HW-abc/PCIe4.0_Slot_SGMII_Ex-Board/README.md

# PCIe4.0_Slot_SGMII_Ex-Board
PCIe4.0 Slot Ex-Board, 4 channel SGMII signals
