HW-abc/PCIe4.0_Slot_SGMII_Ex-Board/HW/03_PCBA/X5H_ETHER_EX-Board_BOM_V001.xlsx

 |  | 文档编号：XXX-XX-XX-xxxxx-xxxx-xx
X5H ETHER EX-Board BOM V001 2025.12.11
Item Number | Quantity | Part Reference | Value | Part Number | Device Size | Tolerance | PCB Footprint | Description | Maker | Note
1 | 10 | B1,B5,B12,B13,B17,B18,B22,B23,B27,B28 | 33 | BLM15PX330SZ1D | 1005 |  | chip1005 | -- | murata
2 | 19 | B2,B3,B4,B6,B7,B8,B9,B10,B11,B14,B15,B16,B19,B20,B21,B24,B25,B26,B29 | 600 | BLM15AX601SZ1D | 1005 |  | chip1005 | -- | murata
3 | 5 | C1,C4,C15,C16,C28 | 10uF | GCM21BC71C106KE36 | 2012 | 10% | chip2012 | -- | murata
4 | 59 | C2,C3,C5,C6,C7,C8,C9,C10,C11,C12,C13,C14,C17,C18,C19,C20,C21,C22,C23,C24,C25,C26,C27,C30,C31,C33,C36,C39,C40,C41,C42,C43,C44,C45,C53,C54,C55,C56,C57,C58,C59,C67,C68,C69,C70,C71,C72,C73,C81,C82,C83,C84,C85,C86,C87,C102,C106,C111,C115 | 0.1uF | GCM155R71C104KA55 | 1005 | 10% | chip1005 | -- | murata
5 | 2 | C29,C32 | 0.22uF | CGA2B2X7R1C224M050B | 1005 | 10% | chip1005 | -- | TDK
6 | 21 | C34,C35,C46,C47,C48,C49,C60,C61,C62,C63,C74,C75,C76,C77,C88,C89,C90,C91,C98,C99,C116 | 0.1uF | GCM155R71H104KE02 | 1005 | 10% | chip1005 | -- | murata
7 | 10 | C37,C38,C51,C52,C65,C66,C79,C80,C93,C94 | 8pF | GCM1555C1H8R0DA16 | 1005 | 0.5pF | chip1005 | -- | murata
8 | 1 | C109 | 1nF | GCM155R71H102KA37 | 1005 | 10% | chip1005 | -- | murata
9 | 4 | C50,C64,C78,C92 | 4.7nF | GCM155R71H472KA37 | 1005 | 10% | chip1005 | -- | murata
10 | 6 | C95,C96,C100,C104,C108,C112 | 10uF | TMK316AB7106KLHT | 3216 | 10% | chip3216 | -- | TAIYO YUDEN
11 | 1 | C97 | 4.7uF | CGA4J1X7R1E475K125AD | 2012 | 10% | chip2012 | -- | TDK
12 | 4 | C101,C105,C110,C114 | 22uF | EMK325B7226KMHP | 3225 | 10% | chip3225 | -- | TAIYO YUDEN
13 | 1 | C113 | 2.2nF | GCM155R71H222KA37 | 1005 | 10% | chip1005 | -- | murata
14 | 2 | CN1,CN2 | Flash E1 | -- |  |  | jtag-e2_254h | -- | -- | pic1
15 | 4 | CN3,CN4,CN5,CN6 | E6S20A-40MT5-Z | E6S20A-40MT5-Z | 21.9x11.0x13.5mm |  | e6s20a-40mt5 | -- | Rosenberger
16 | 1 | CN7 | PJ-063AH | PJ-063AH | 13.0x10.0x0.9mm |  | pj-063ah | -- | Semtec
17 | 1 | D1 | PMEG3030EP | PMEG3030EP | 2.5x4.7x1.1mm |  | pmeg3030ep | -- | nexperia | Replacement: PMEG3020EP
18 | 4 | L1,L2,L3,L4 | ACM2012H-900 | ACM2012H-900-2P-T03 | 2.0x1.2x1.3mm |  | acm2012h-900-2p-t03 | -- | TDK
19 | 4 | L5,L6,L7,L8 | 1.0uH | IHLP1212BZEV1R0M5A | 3.3x3.3x2.0mm |  | ihlp1212bz5a | -- | Vishay
20 | 5 | LED1,LED2,LED3,LED4,LED5 | Amber | IN-S42BT5A | 1005 |  | led1005 | -- | Inolux
21 | 2 | Q1,Q3 | NX3008NBKW | NX3008NBKW,115 | 2.1x2.0x1.1mm |  | nx3008nbkw | -- | Nexperia | Replacement: NTS4409N
22 | 1 | Q2 | IPD30N03S4L | IPD30N03S4L-09 | 10.0x6.5x2.4mm |  | ipd30n03s4l | -- | Infineon
23 | 16 | R7,R10,R13,R20,R24,R25,R33,R37,R38,R46,R48,R51,R60,R79,R80,R81 | 0 | ERJ-2GE0R00X | 1005 | 5% | chip1005 | -- | Panasonic
24 | 7 | R1,R2,R5,R6,R8,R9,R62 | 10K | ERJ-2GEJ103X | 1005 | 5% | chip1005 | -- | Panasonic
25 | 17 | R4,R14,R17,R19,R26,R29,R31,R32,R39,R42,R44,R45,R52,R55,R57,R58,R59 | 4.7K | ERJ-2GEJ472X | 1005 | 5% | chip1005 | -- | Panasonic
26 | 13 | R11,R12,R16,R22,R23,R28,R35,R36,R41,R49,R50,R53,R78 | 1K | ERJ-2GEJ102X | 1005 | 5% | chip1005 | -- | Panasonic
27 | 4 | R15,R27,R40,R54 | 100K | ERJ-2GEJ104X | 1005 | 5% | chip1005 | -- | Panasonic
28 | 4 | R21,R34,R47,R61 | 4.99K | ERJ-2RKF4991X | 1005 | 1% | chip1005 | -- | Panasonic
29 | 1 | R63 | 47K | ERJ-2GEJ473X | 1005 | 5% | chip1005 | -- | Panasonic
30 | 6 | R64,R67,R71,R73,R75,R77 | 100.0K | ERJ-2RKF1003X | 1005 | 1% | chip1005 | -- | Panasonic
31 | 2 | R65,R68 | 40.2K | ERJ-2RKF4022X | 1005 | 1% | chip1005 | -- | Panasonic
32 | 1 | R69 | 21.0K | ERJ-2RKF2102X | 1005 | 1% | chip1005 | -- | Panasonic
33 | 1 | R70 | 82.0K | ERJ-2RKF8202X | 1005 | 1% | chip1005 | -- | Panasonic
34 | 2 | R72,R76 | 7.15K | ERJ-2RKF7151X | 1005 | 1% | chip1005 | -- | Panasonic
35 | 1 | R74 | 49.9K | ERJ-2RKF4992X | 1005 | 1% | chip1005 | -- | Panasonic
36 | 1 | SW1 | TACK | SKRKAGE020 | 3.9x2.9x1.5mm |  | skrkage020 | -- | ALPS
37 | 4 | SW2,SW3,SW4,SW5 | CHS-01A | CHS-01A | 5.6x2.5x2.5mm |  | chs-01a | -- | Nidec
38 | 1 | U1 | U2C_292P | PRBG0292GC-A | 17.0x17.0x1.9mm |  | u2c8_292p_080p_040b | -- | Renesas
39 | 4 | U2,U3,U4,U5 | 88Q2112 | 88Q2112 | 6.0x6.0x0.9mm |  | 88q2112_48p | -- | Marvell
40 | 4 | U6,U7,U8,U9 | TPS62903 | TPS62903QRYTRQ1 | 2.0x2.1x0.9mm |  | tps62903q1 | -- | Ti
41 | 1 | U10 | APX803S00 | APX803S00-29SR-7 | 3.0x2.4x1.1mm |  | apx810sr | -- | Diodes
42 | 1 | X1 | 20.000MHz | XRCGE20M000F3A1BR0 | 2016 | 30ppm | xtal4_crs2016 | -- | Murata
43 | 4 | X2,X3,X4,X5 | 25.000MHz | CX2016SA25000D0FPLG1 | 2016 | 10ppm | xtal4_crs2016 | -- | Kyocera
Not Mounted on Board
Item Number | Quantity | Part Reference | Value | Part Number | Device Size | Tolerance | PCB Footprint | Description | Maker | Note
1 | 1 | C103,C107 | 1nF* | GCM155R71H102KA37 | 1005 | 10% | chip1005 | -- | murata
2 | 6 | R3,R82,R83,R84,R85,R86 | 0* | ERJ-2GE0R00X | 1005 | 5% | chip1005 | -- | Panasonic
3 | 4 | R18,R30,R43,R56 | 4.7K* | ERJ-2GEJ472X | 1005 | 5% | chip1005 | -- | Panasonic
4 | 1 | R66 | 249.0K* | ERJ-2RKF2493X | 1005 | 1% | chip1005 | -- | Panasonic
5 | 1 | R87 | 100K* | ERJ-2GEJ104X | 1005 | 5% | chip1005 | -- | Panasonic
