HW-abc/PCIe4.0_Slot_SGMII_Ex-Board/HW/02_PCB/ether_ex_board_v001_1211.pdf

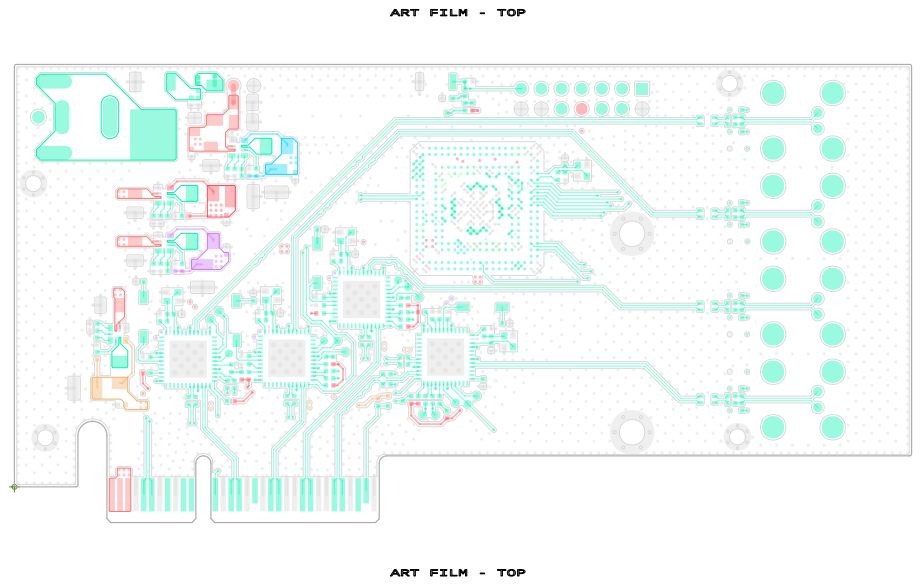
[picture p1: page 1]

ART FILM - TOP

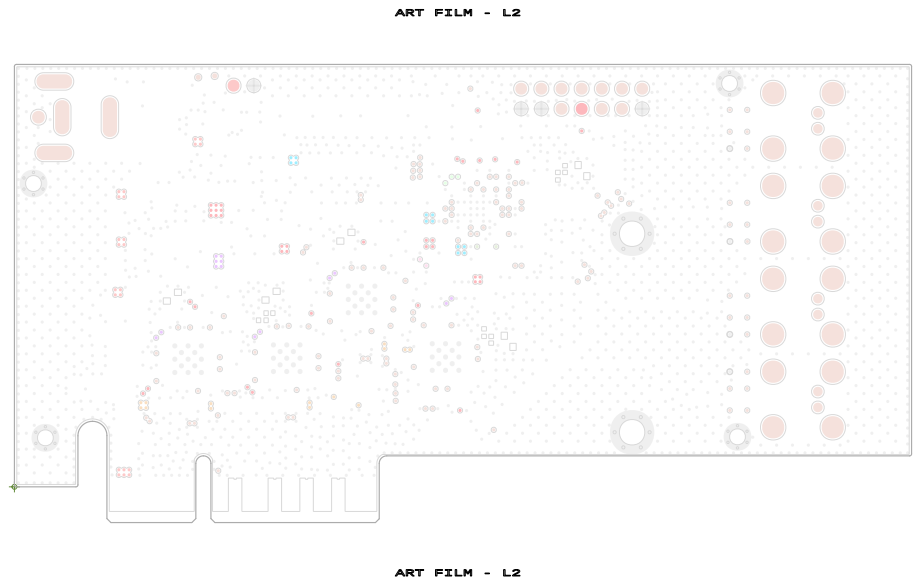
[picture p2: page 2]
ART FILM - L2

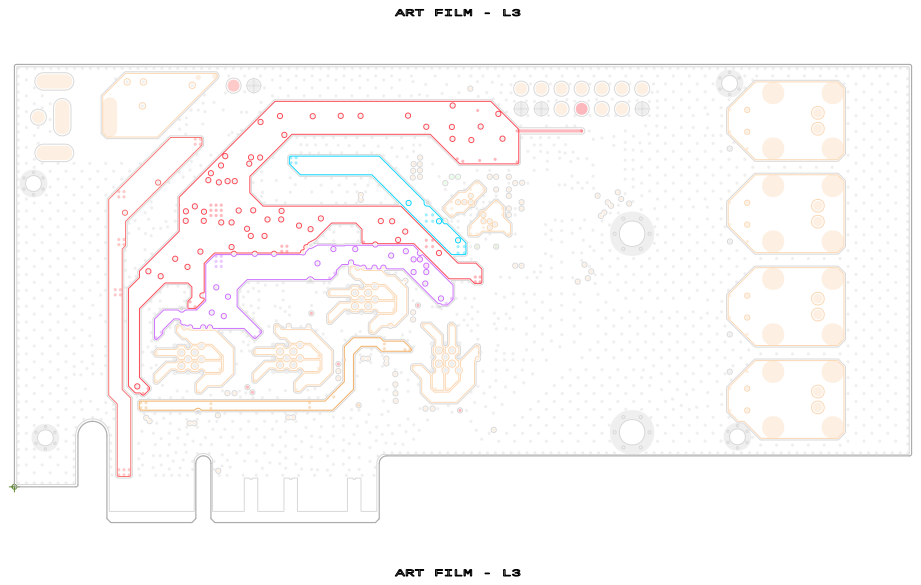
[picture p3: page 3]
ART FILM - L3

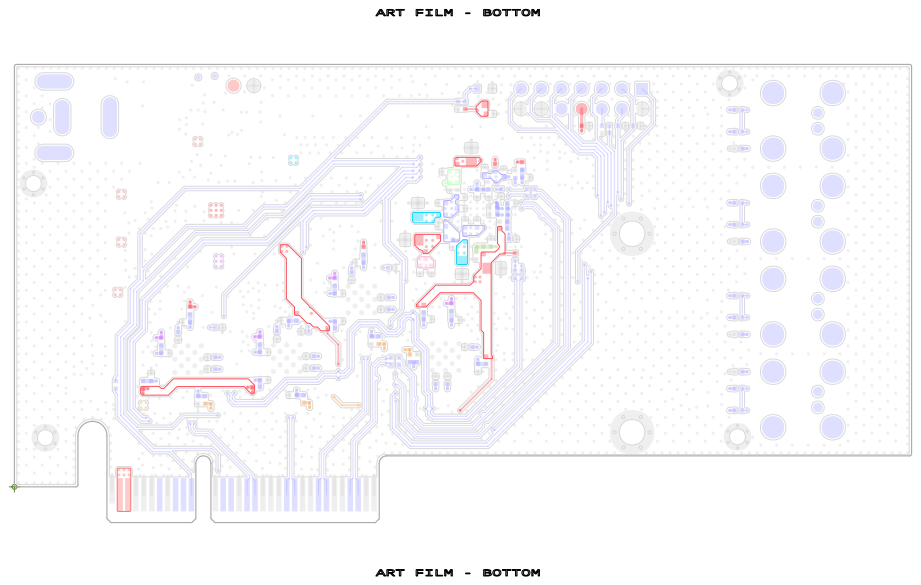
[picture p4: page 4]

ART FILM - BOTTOM

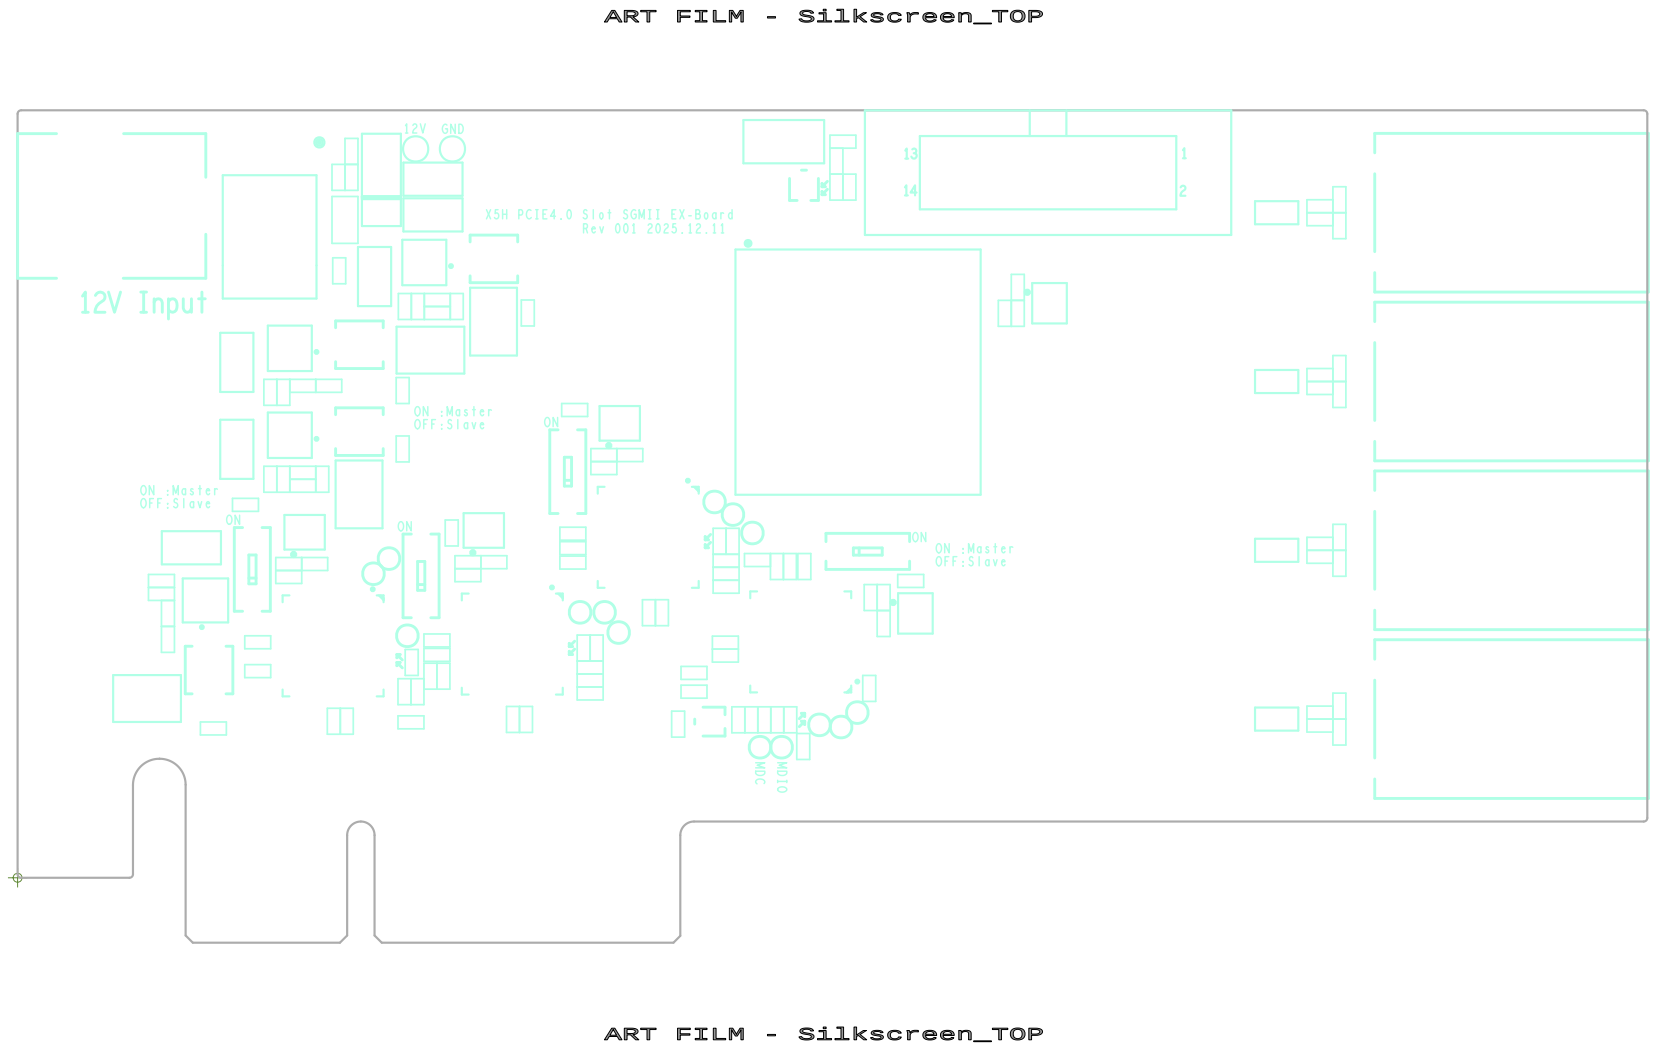
[picture p5: page 5]
ART FILM - Silkscreen_TOP; 12V Input; OFF:Slave; ON :Master; ON :Master OFF:Slave; GND; Rev 001 2025.12.11; MDC; MDIO

X5H PCIE4.0 Slot SGMII EX-Board

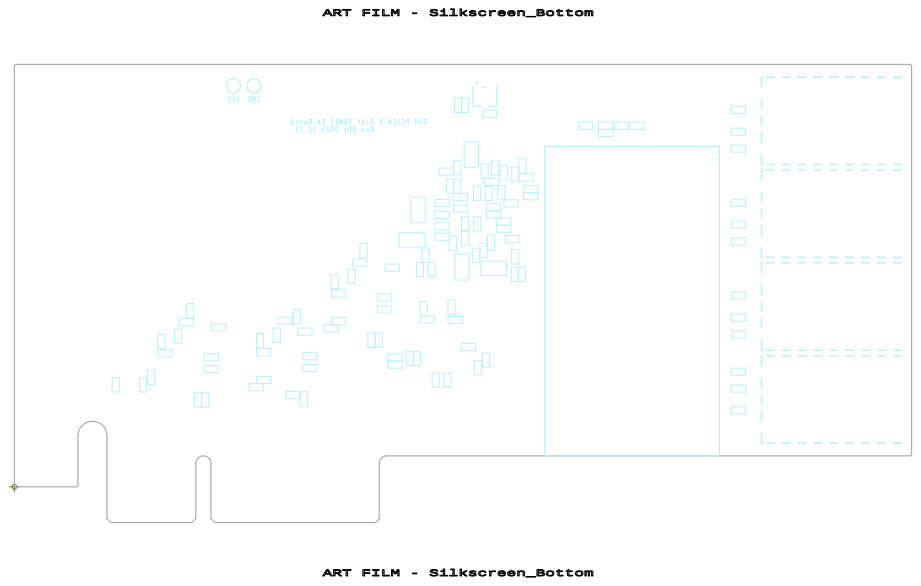
[picture p6: page 6]
ART FILM - Silkscreen_Bottom

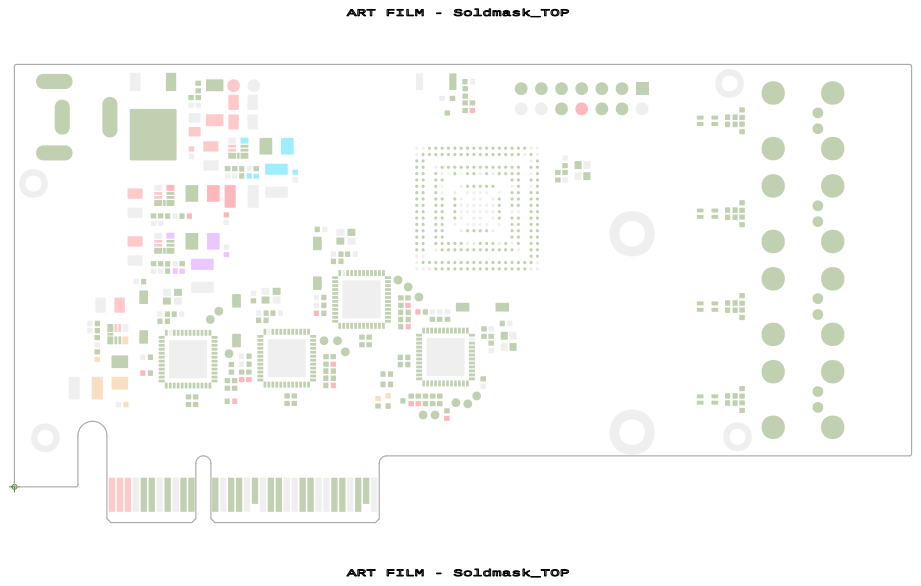
[picture p7: page 7]
ART FILM - Soldmask_TOP

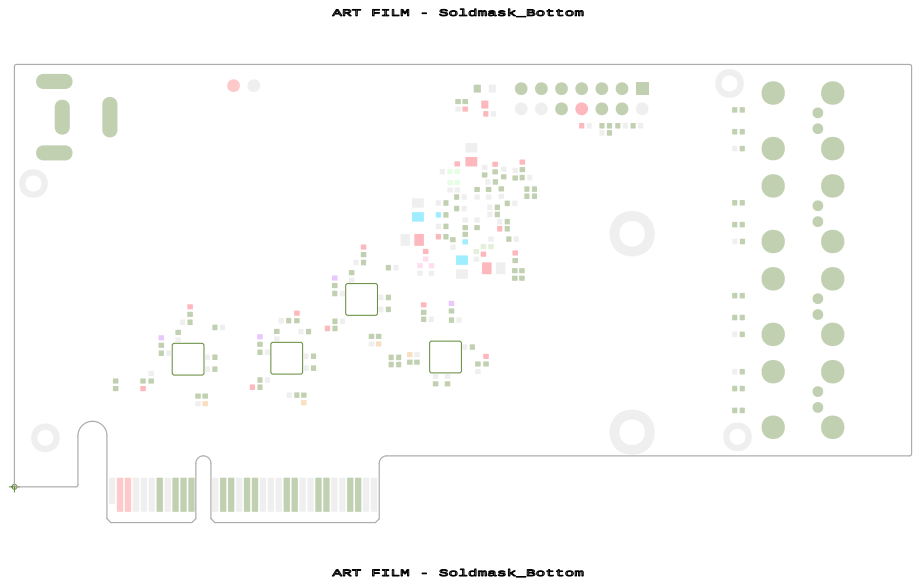
[picture p8: page 8]
ART FILM - Soldmask_Bottom

# R64C98 C97 C99 R63 R62 L8

12VR16

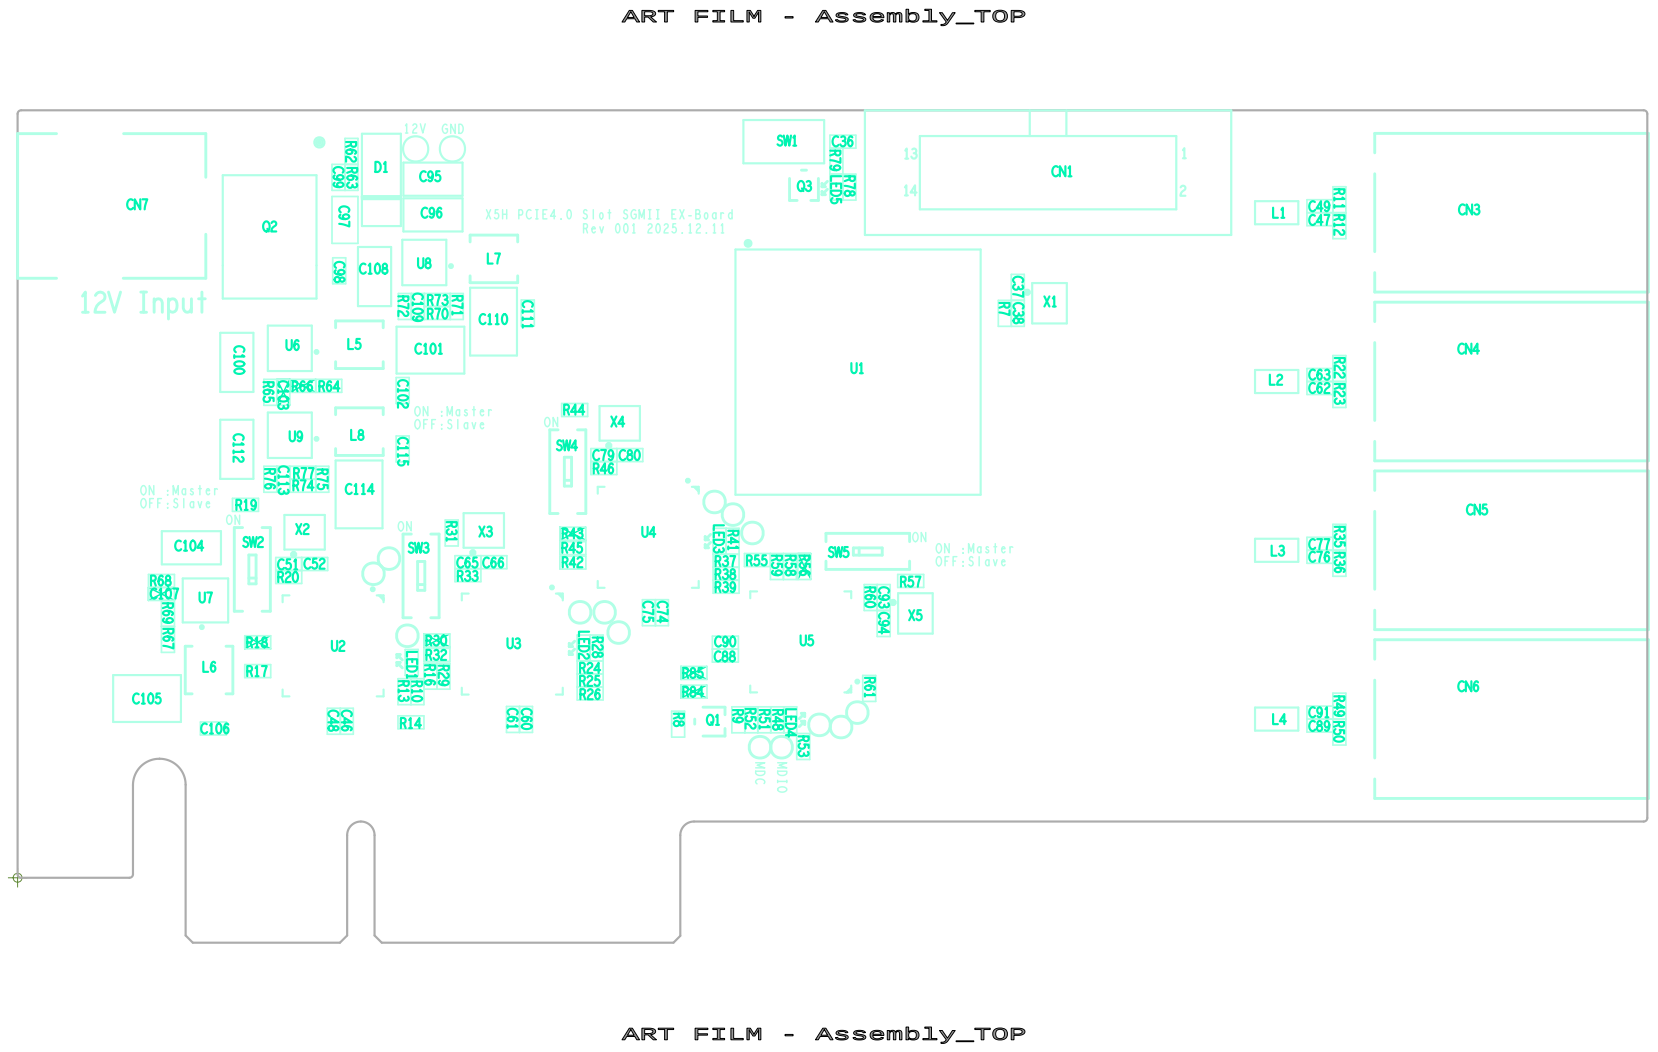
[picture p9: page 9]

X5H PCIE4.0 Slot SGMII EX-Board C61 C60

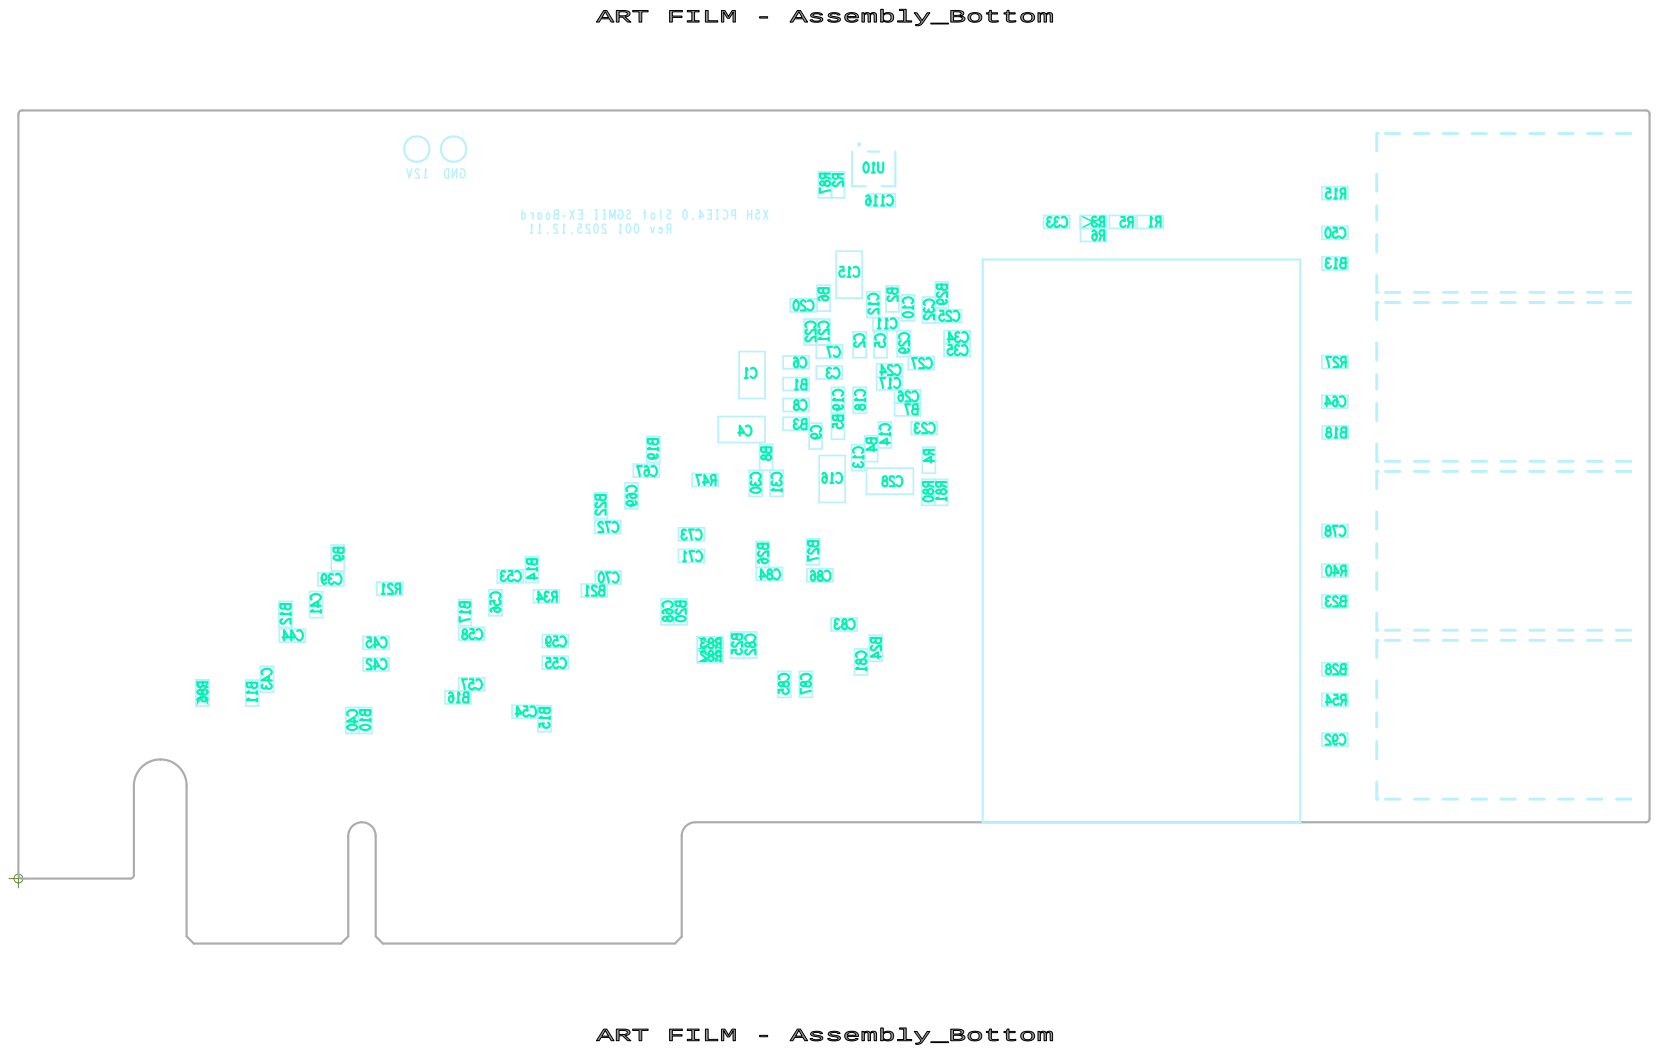
[picture p10: page 10]

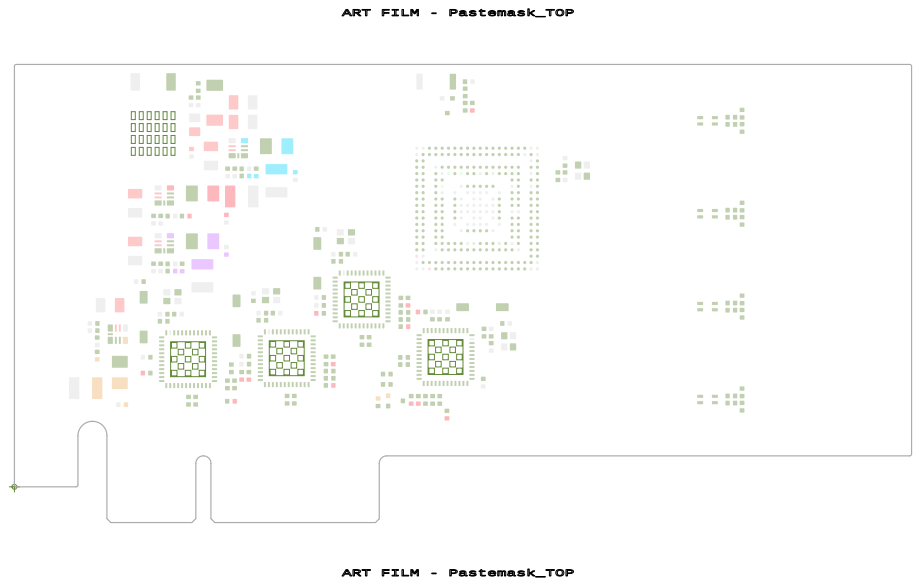
[picture p11: page 11]
ART FILM - Pastemask_TOP

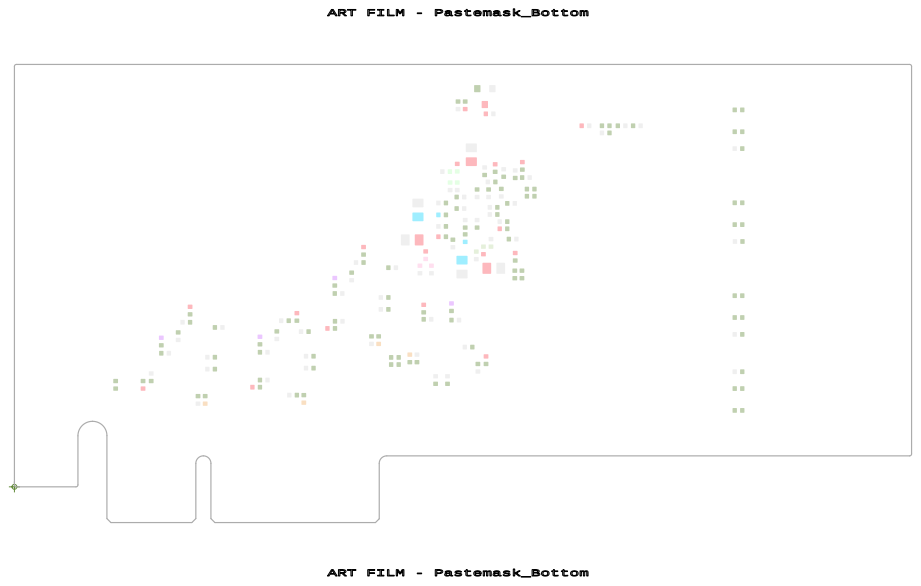
[picture p12: page 12]
ART FILM - Pastemask_Bottom

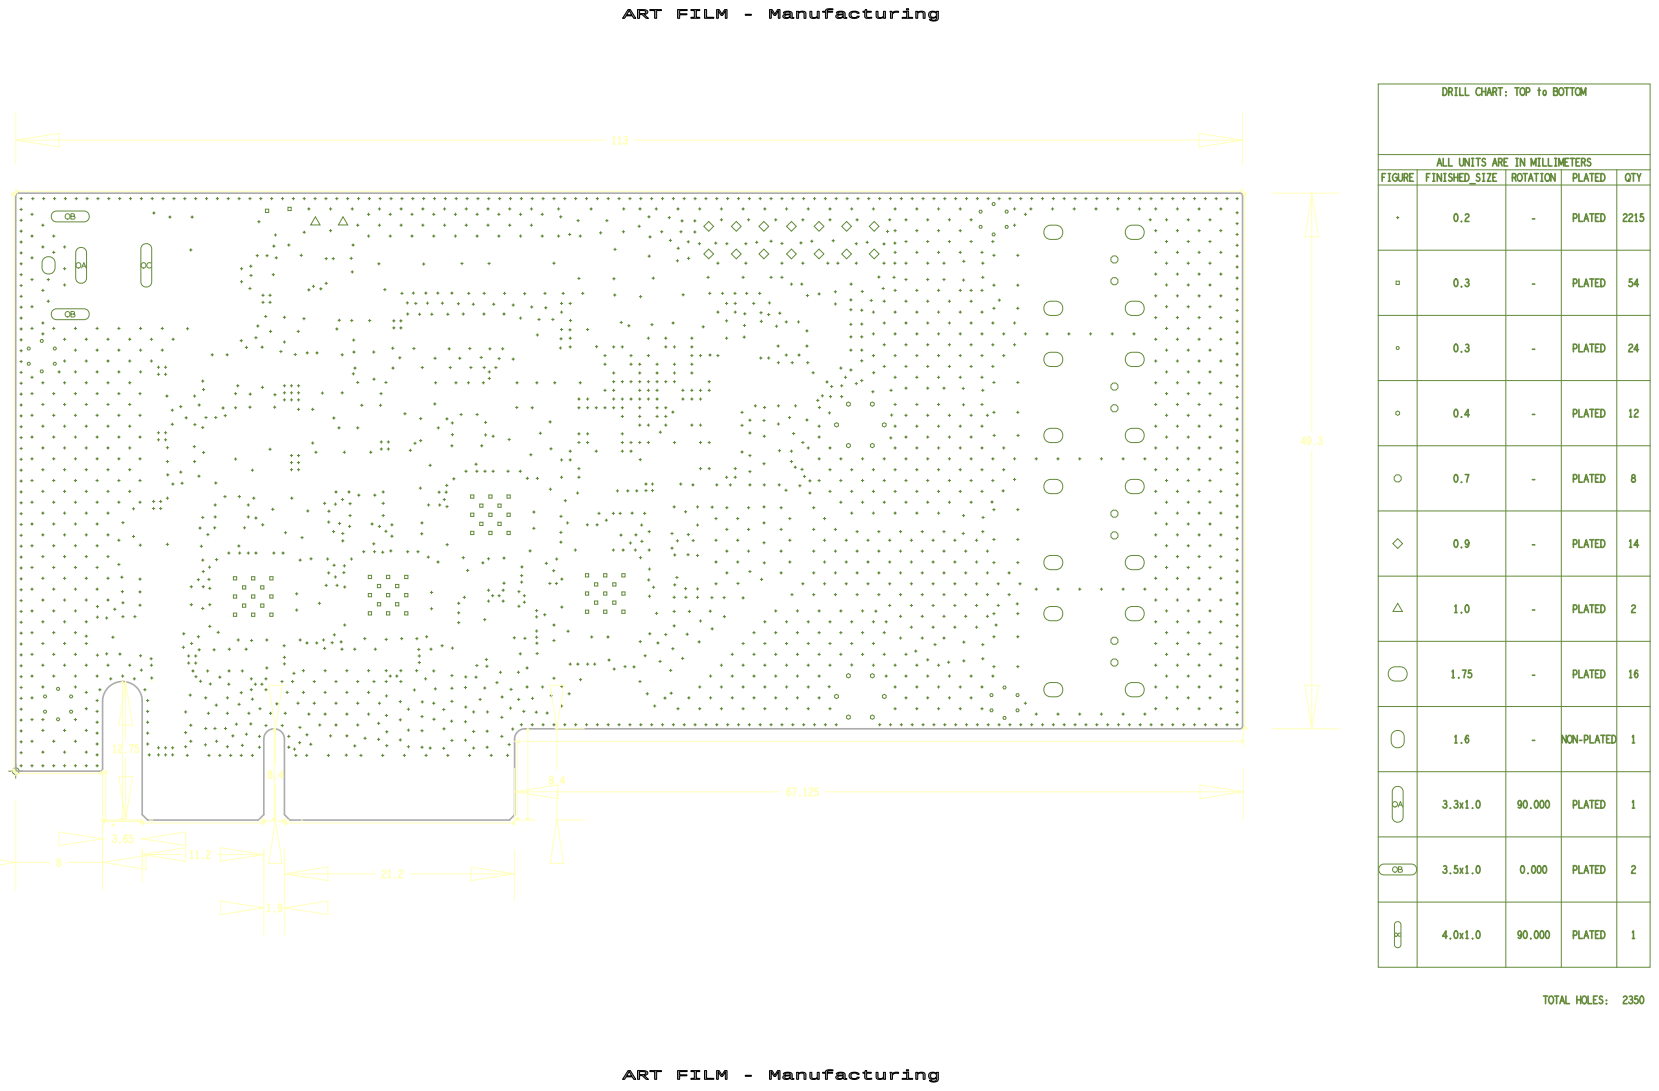
[picture p13: page 13]
FIGURE; ROTATION; TOTAL HOLES:; NON-PLATED; PLATED; QTY

ART FILM - Manufacturing

DRILL CHART: TOP to BOTTOM

ALL UNITS ARE IN MILLIMETERS
FINISHED_SIZE
