HW-abc/PCIe4.0_Slot_SGMII_Ex-Board/HW/01_SCH/ether_ex_board_v001.pdf

# max 1.0[A]

# max. 2A

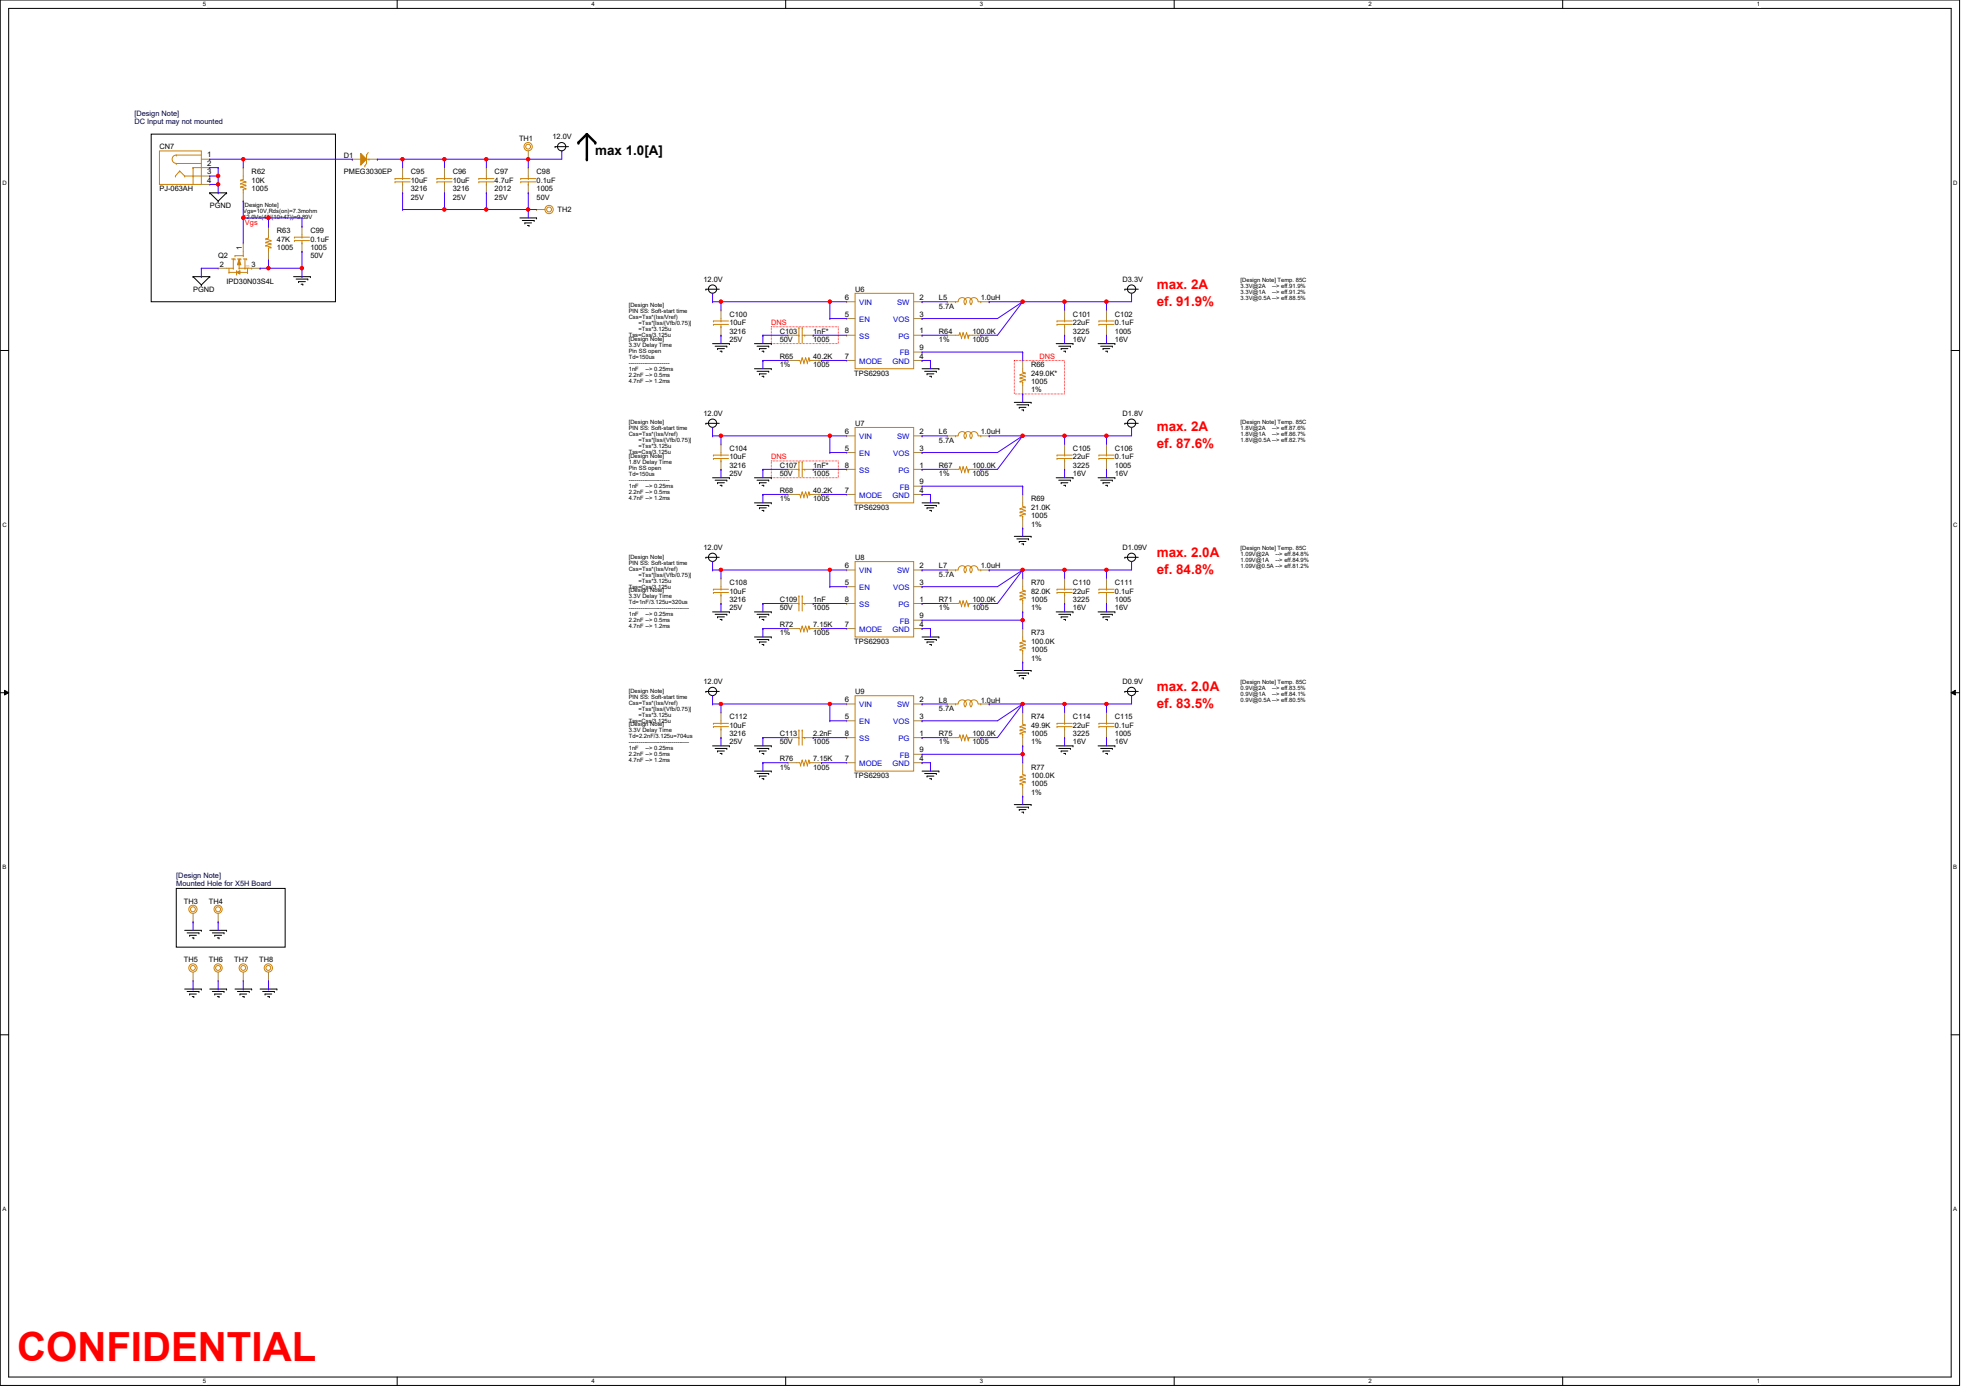
[picture p14: page 1]

[Design Note]
DC Input may not mounted

PIN SS: Soft-start time
Css=Tss*(Iss/Vref)
=Tss*[Iss/(Vfb/0.75)]
=Tss*3.125u
Tss=Css/3.125u [Design Note]
3.3V Delay Time
Pin SS open

Tss=Css/3.125u
1.8V Delay Time

Mounted Hole for X5H Board

# Preliminary

88Q2112

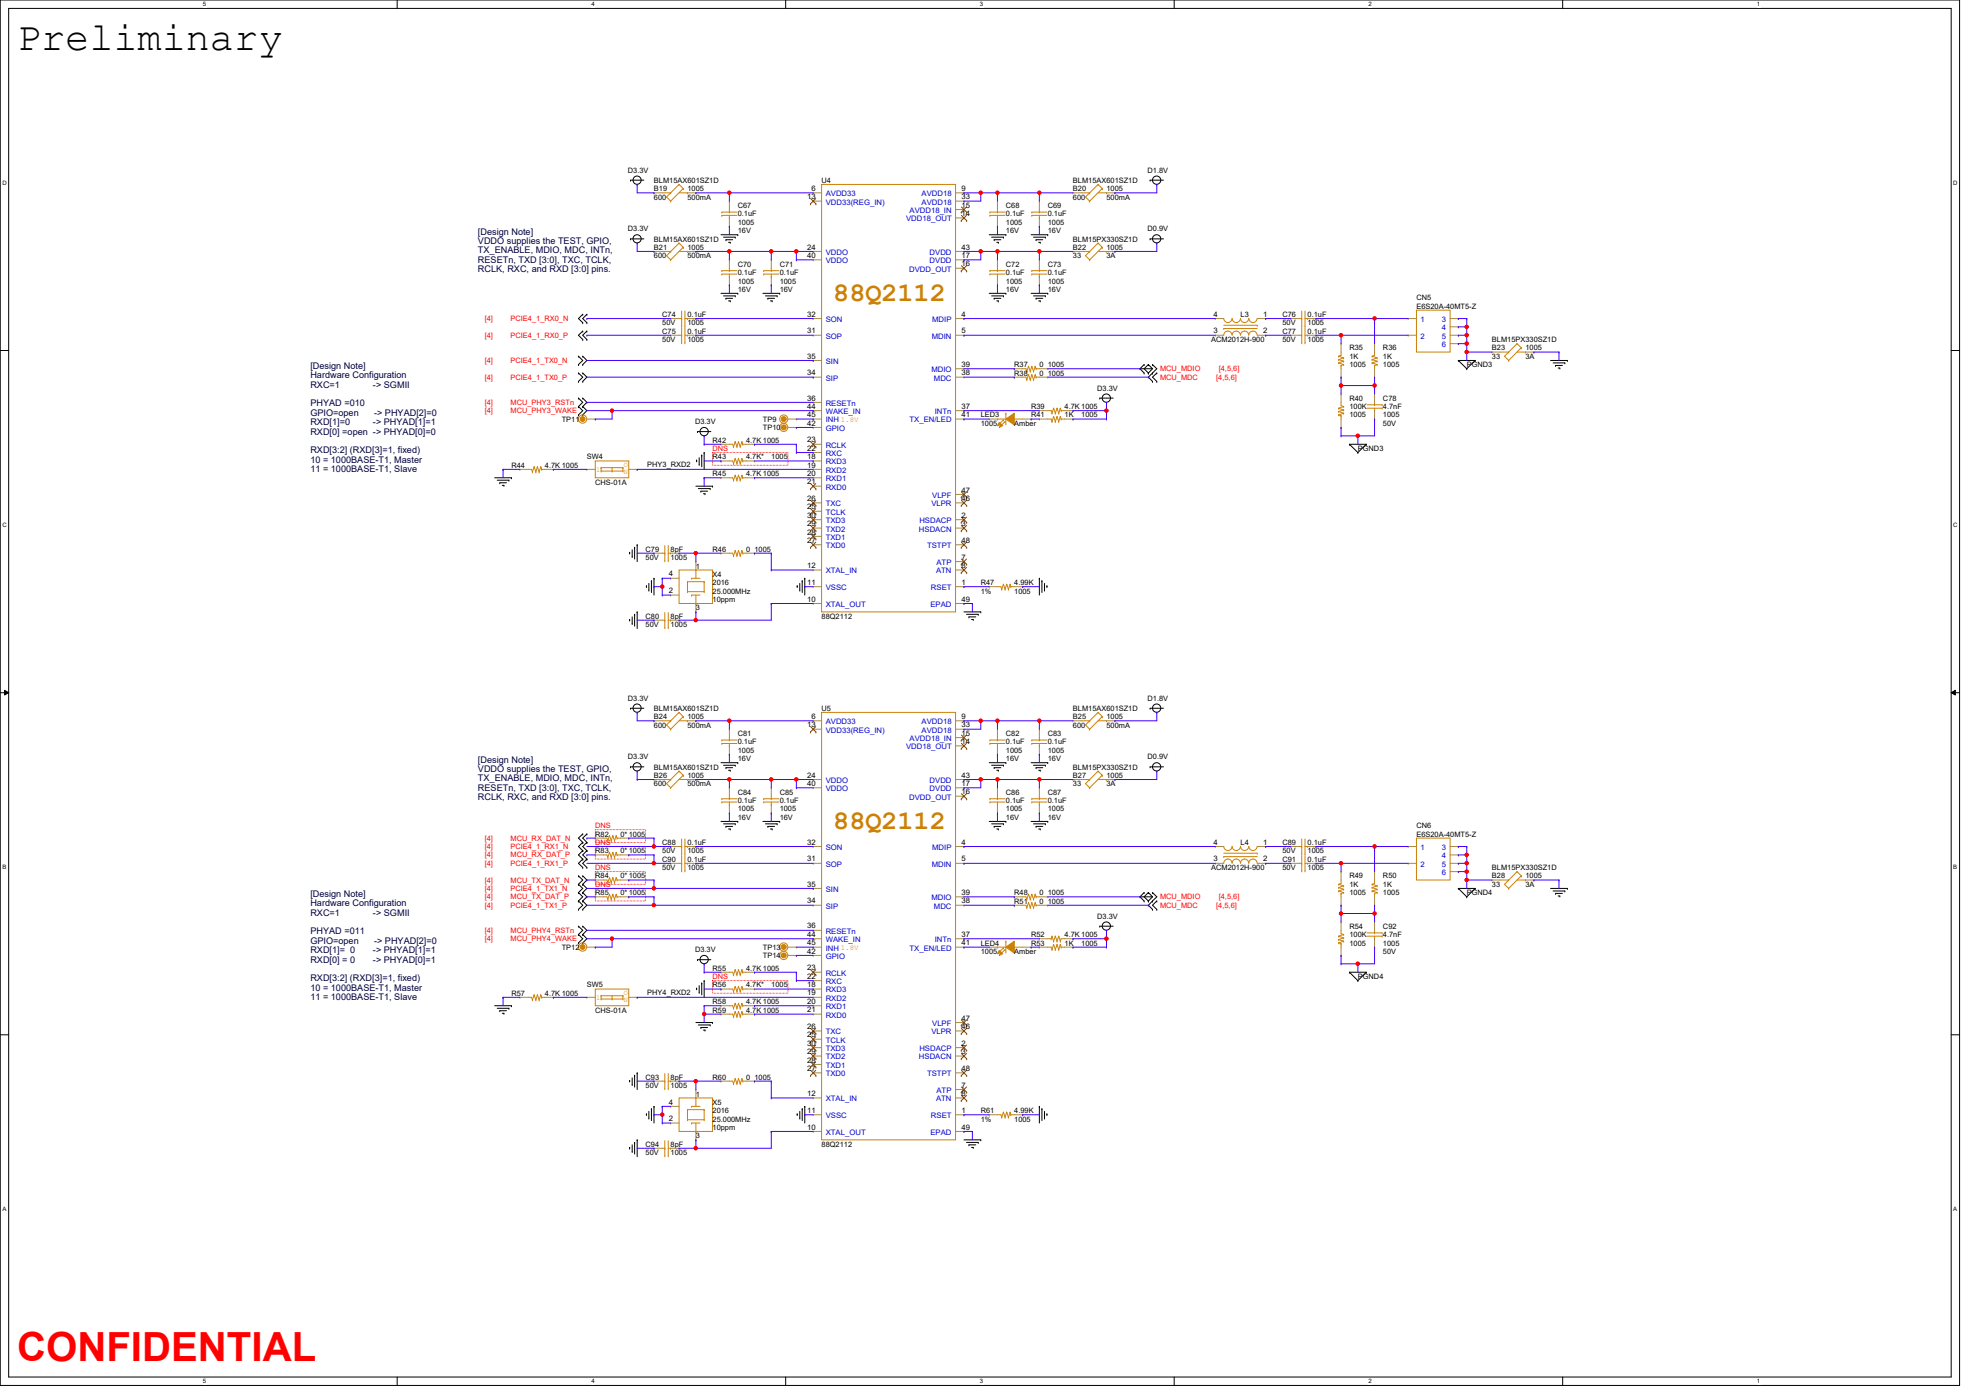
[picture p15: page 2]

[Design Note]
VDDO supplies the TEST, GPIO,
TX_ENABLE, MDIO, MDC, INTn,
RESETn, TXD [3:0], TXC, TCLK,
RCLK, RXC, and RXD [3:0] pins.

88Q2112

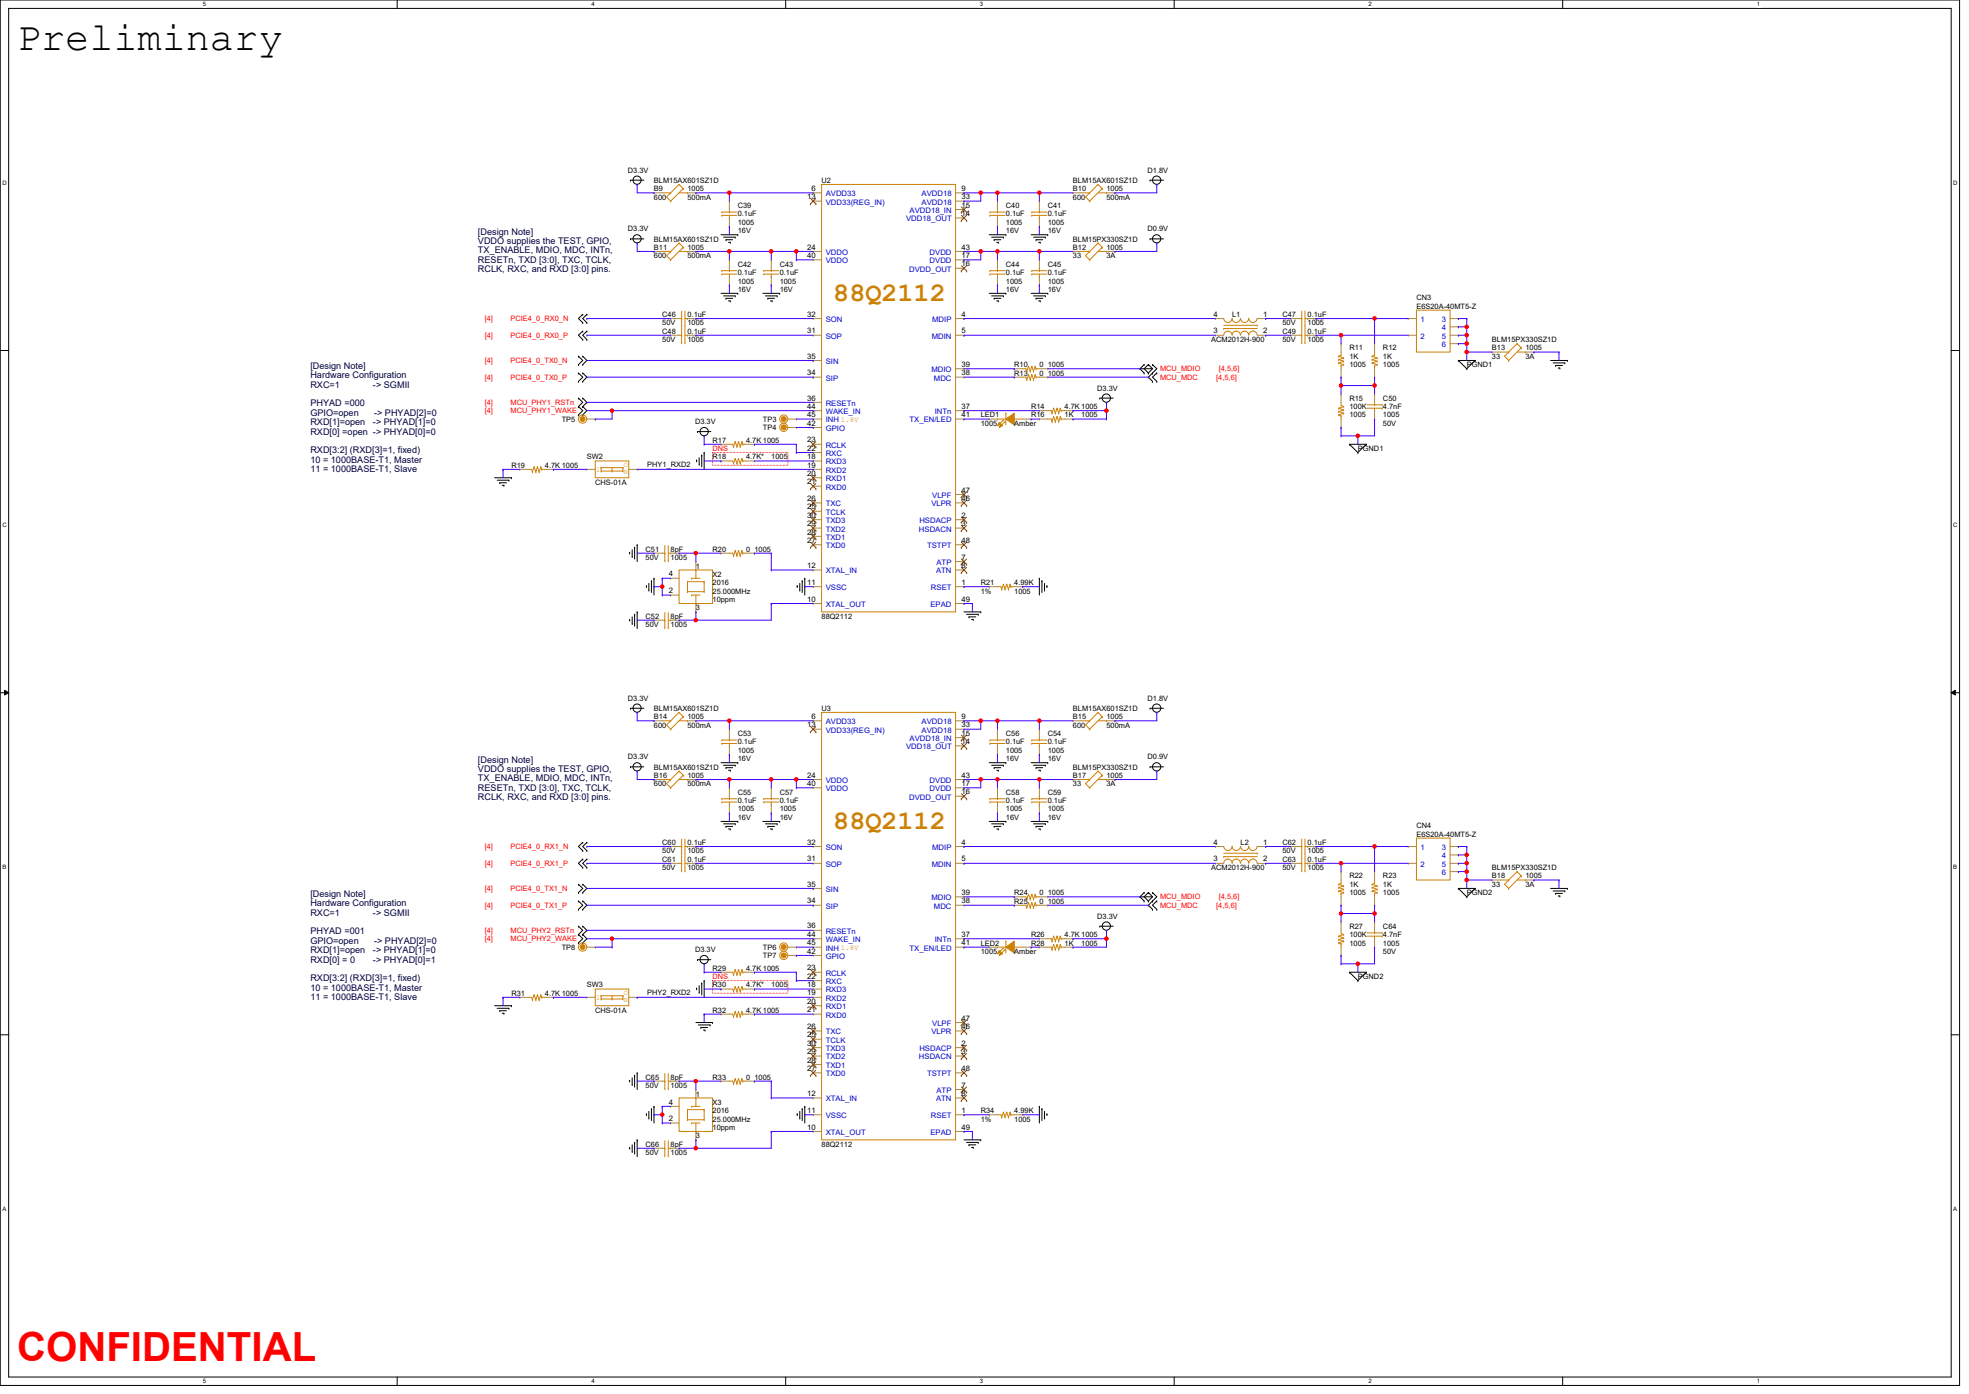
[picture p16: page 3]
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

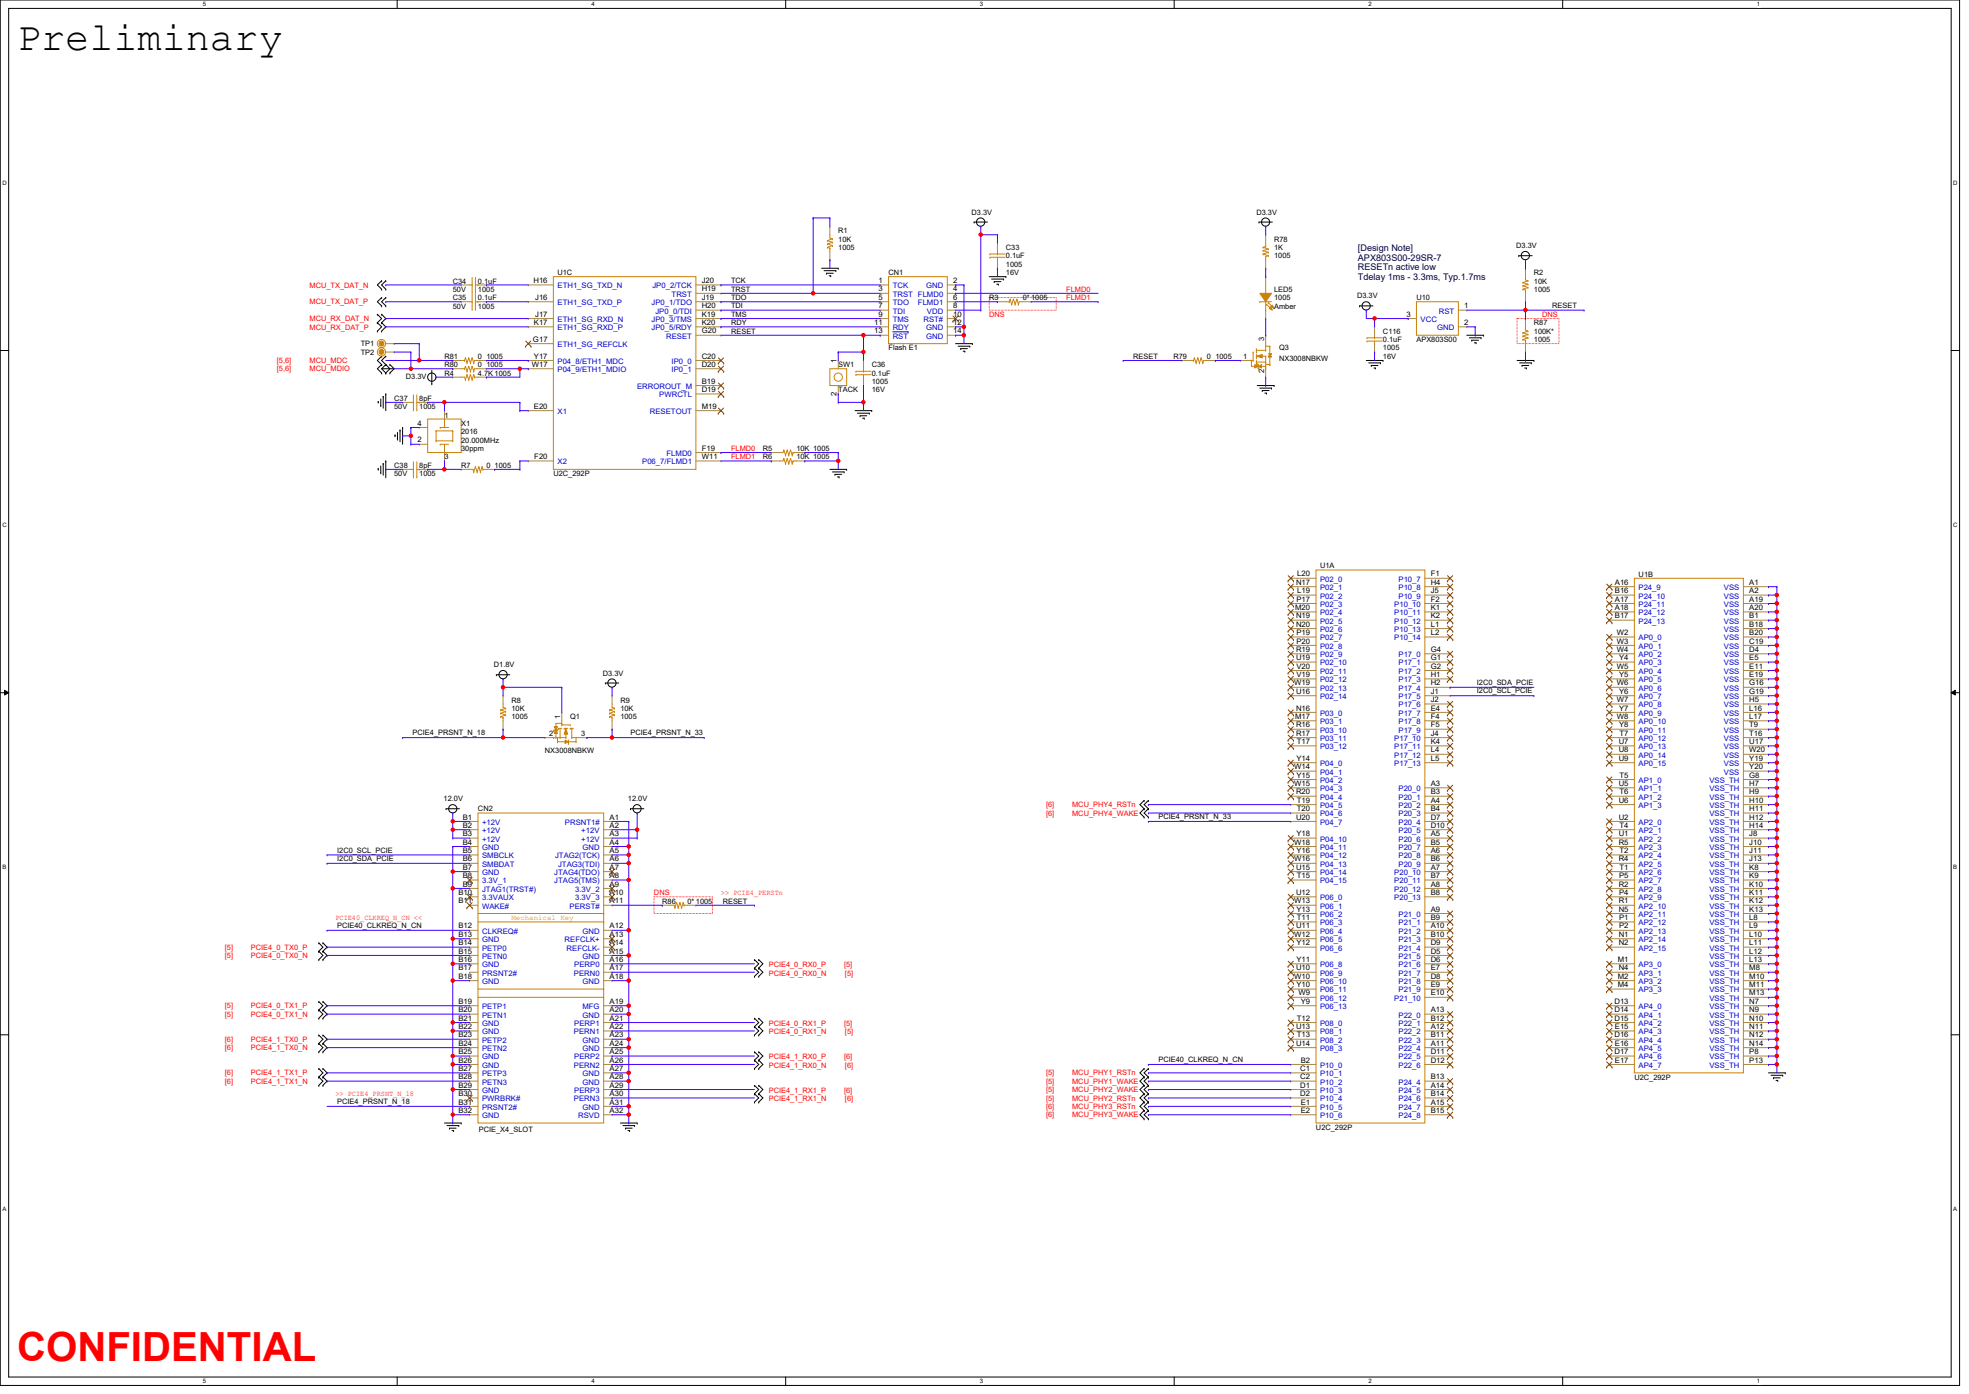
[picture p17: page 4]

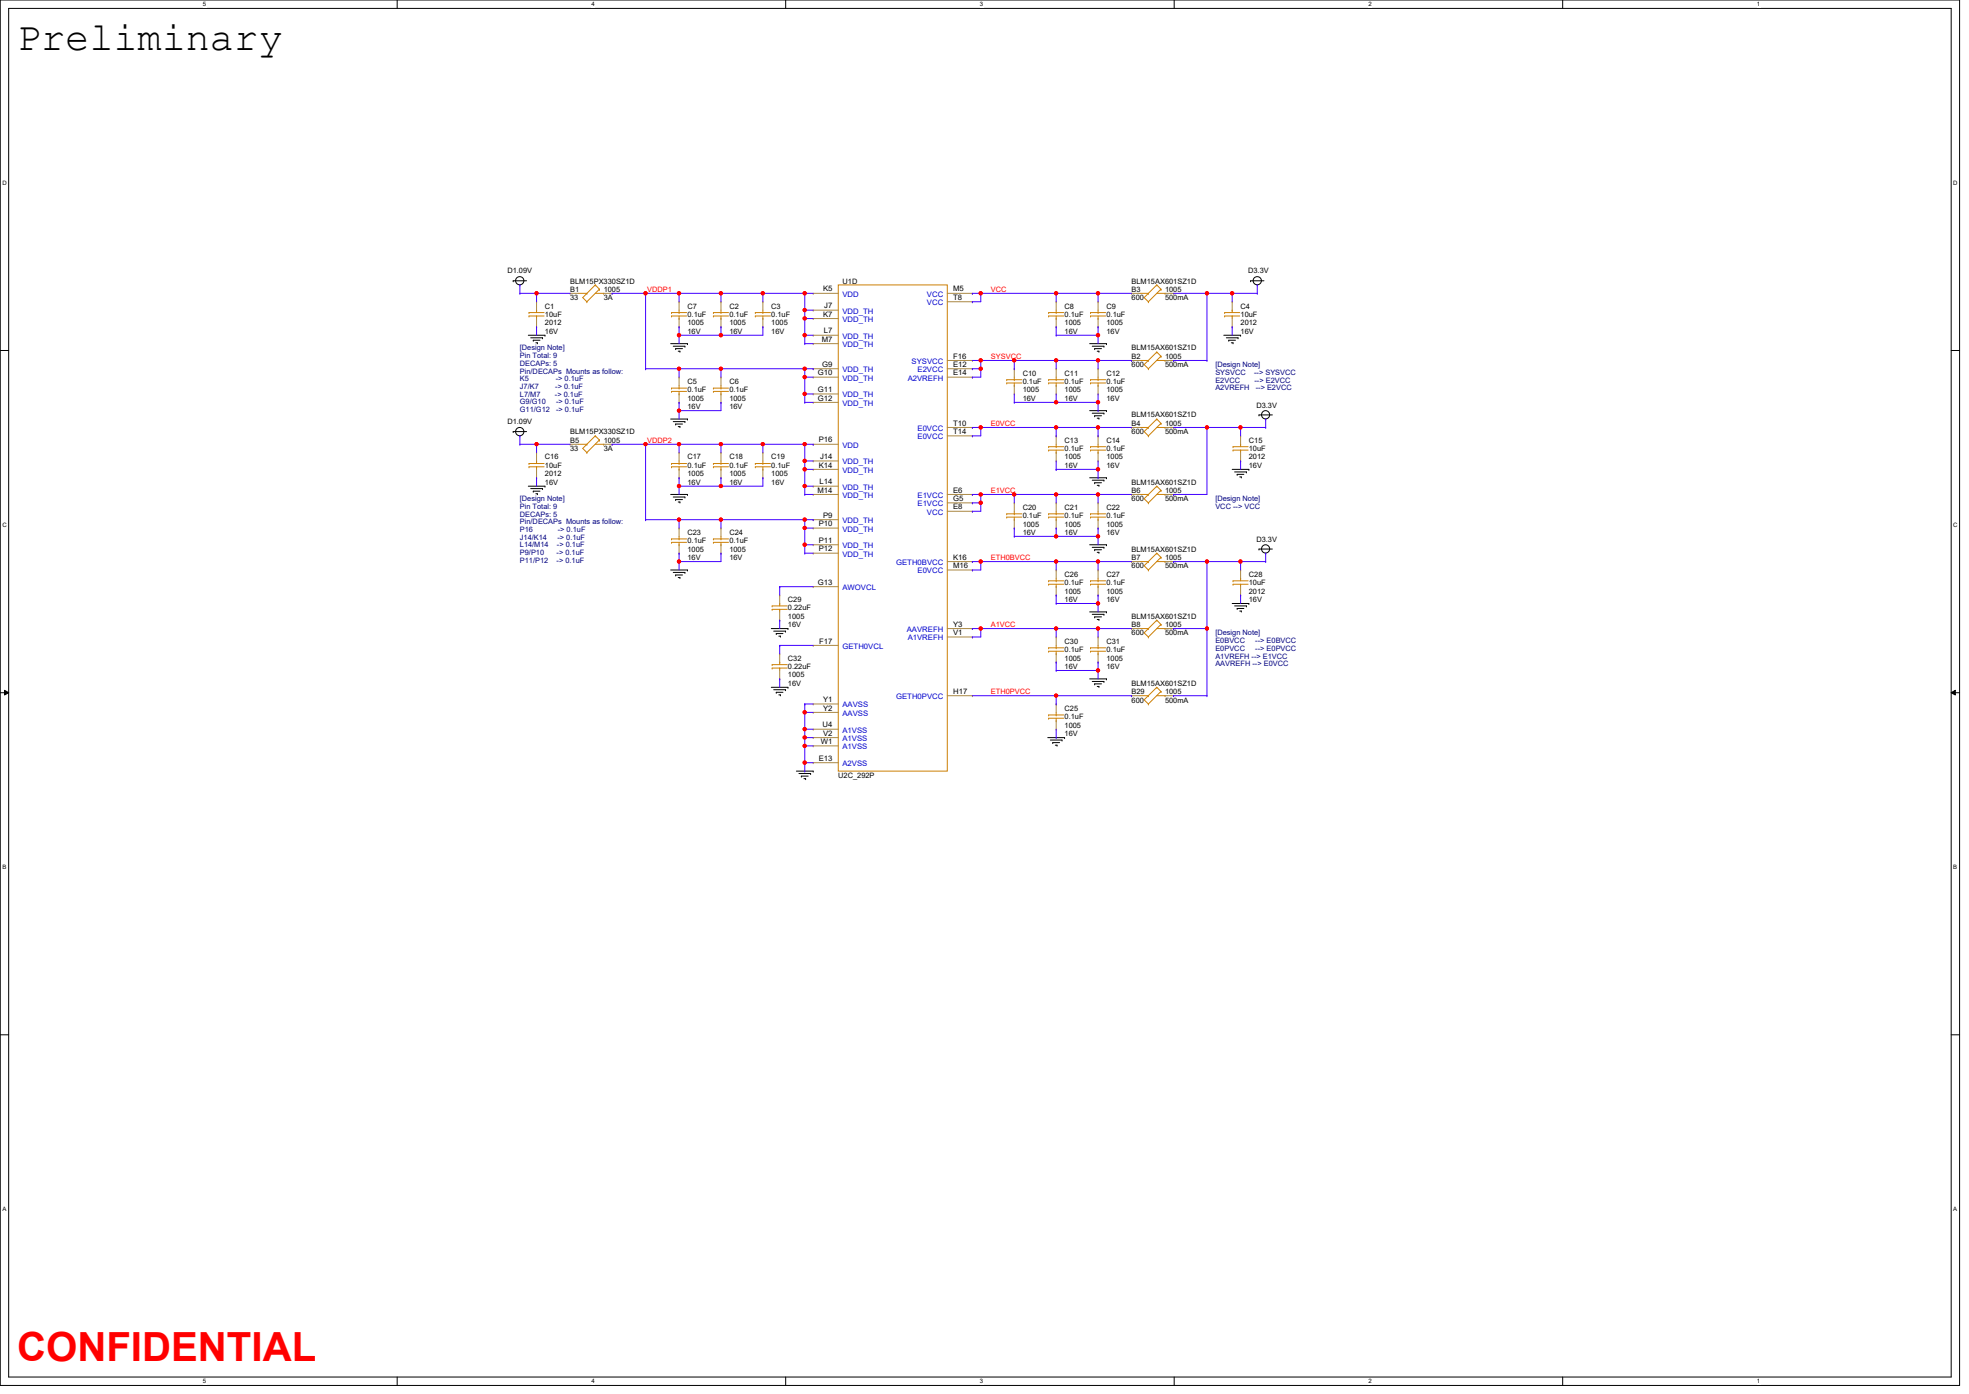
[picture p18: page 5]

D1.09V

# MCU PWR

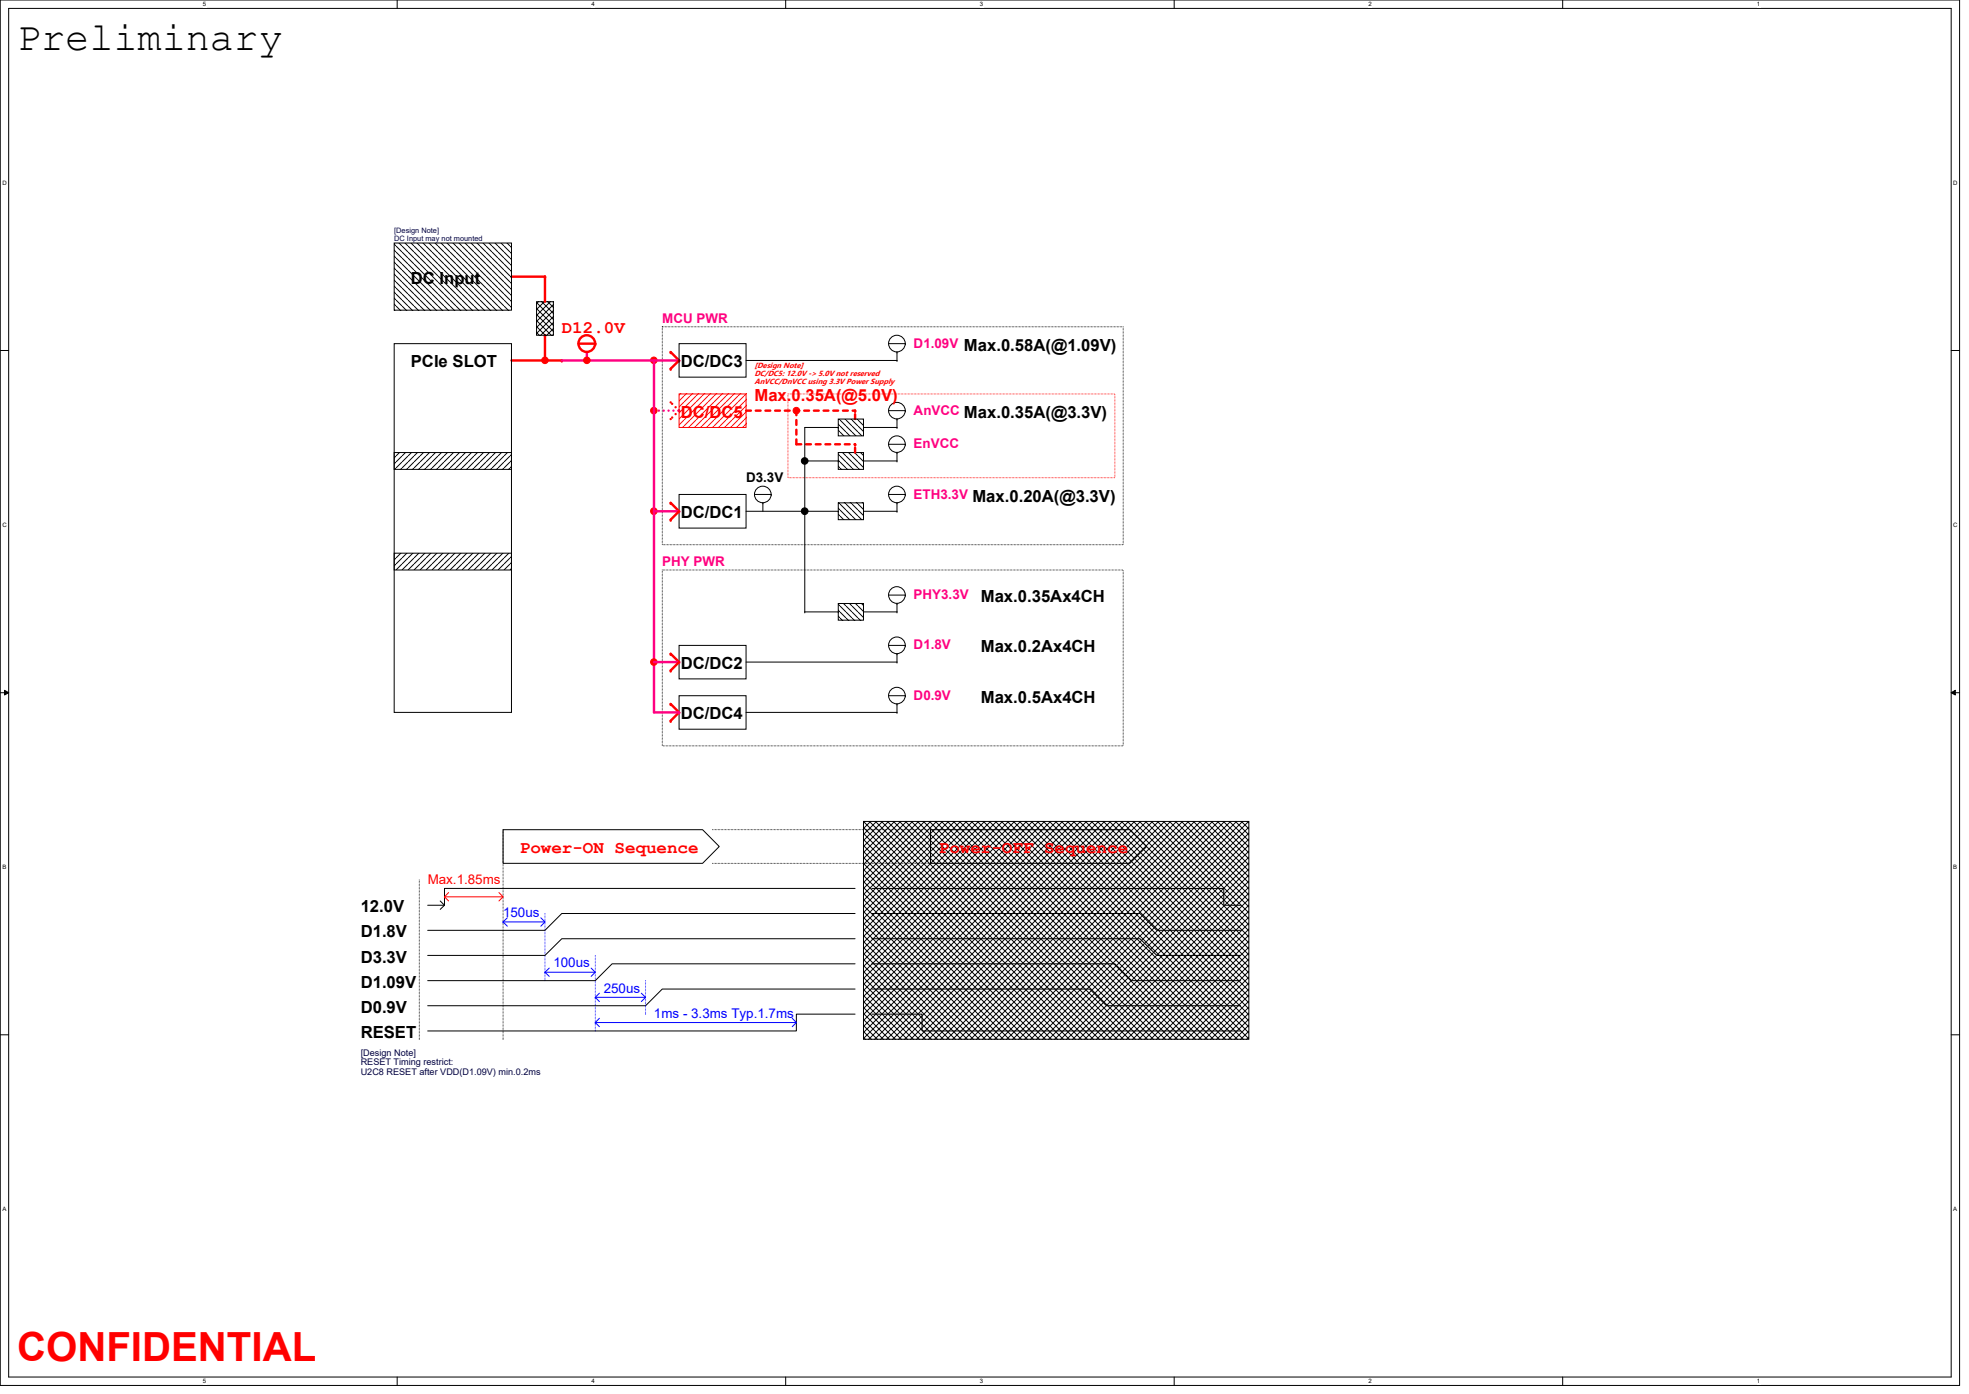
[picture p19: page 6]
PCIe SLOT; Max.0.35Ax4CH; AnVCC; PHY PWR; Max.0.20A(@3.3V); PHY3.3V; EnVCC; Max.0.5Ax4CH; ETH3.3V; Max.0.2Ax4CH; Max.0.58A(@1.09V); Max.0.35A(@3.3V); DC Input; RESET; 1ms - 3.3ms Typ.1.7ms; Max.1.85ms

[Design Note]
DC Input may not mounted

DC/DC5: 12.0V -> 5.0V not reserved
AnVCC/DnVCC using 3.3V Power Supply
Max.0.35A(@5.0V)

Power-ON Sequence

Power-OFF Sequence

RESET Timing restrict:
U2C8 RESET after VDD(D1.09V) min.0.2ms

# Preliminary

# R7F702600AFABB-C

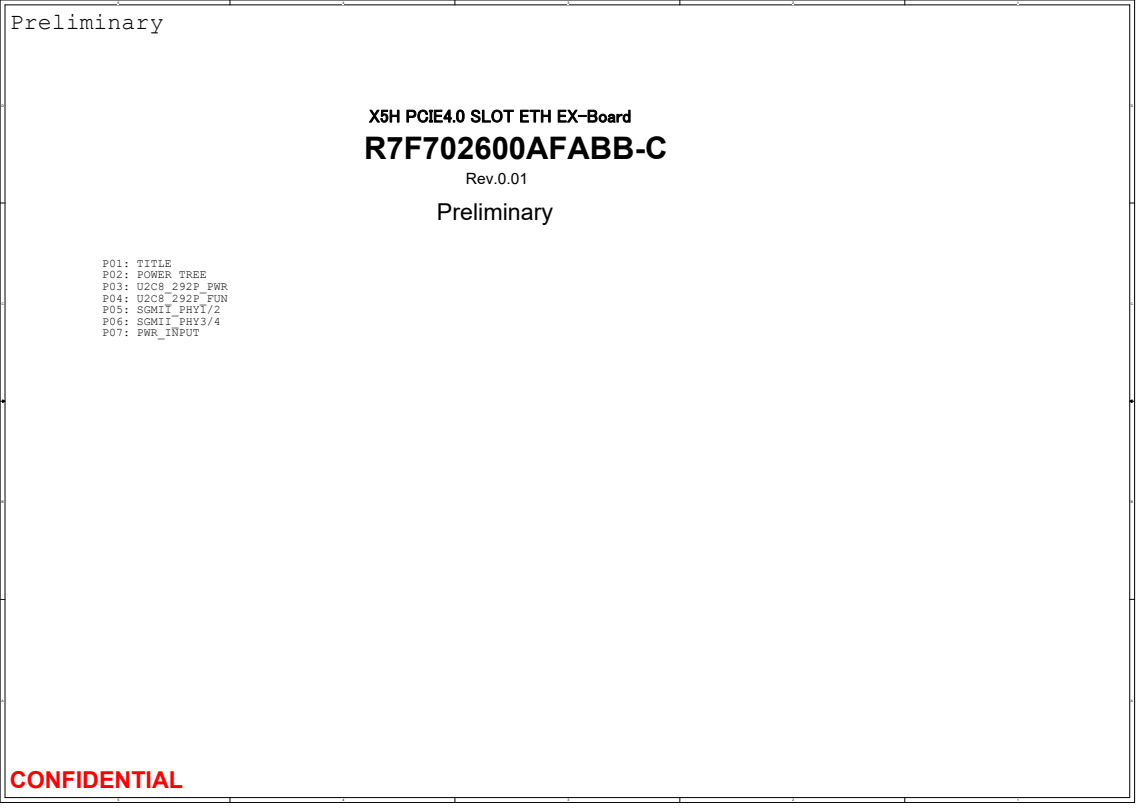
[picture p20: page 7]
P01: TITLE P02: POWER TREE P03: U2C8_292P_PWR P04: U2C8_292P_FUN P05: SGMII_PHY1/2 P06: SGMII_PHY3/4 P07: PWR_INPUT; Rev.0.01

X5H PCIE4.0 SLOT ETH EX-Board CONFIDENTIAL
